Namith-kp/Laser-Radar/(commit log)

2026-10-21 Initial commit: laser turret
    [results.csv]
2026-10-21 Update and Improvements
    [results.csv]
